teebalroshood/ENCE-3231_EmbeddedSys/2_wheel_project/components/ESP8266-01_ESP-01/step/ESP8266-01_ESP-01.step

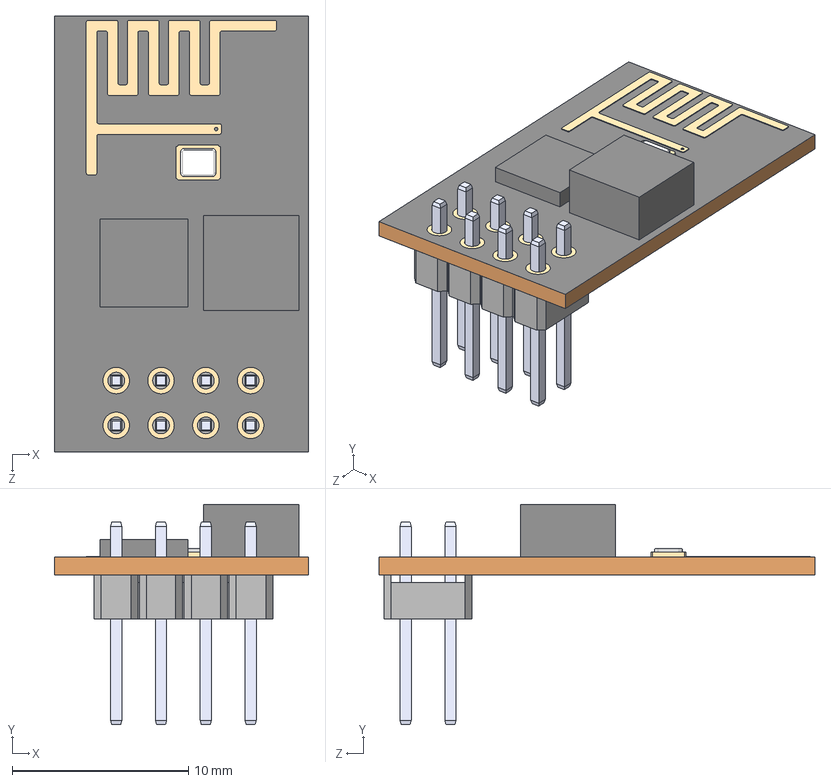
[picture p16: CAD file, 2026-05-04]
2_wheel_project/components/ESP8266-01_ESP-01/step/ESP8266-01_ESP-01.step
14.4 x 12.5 x 24.7 mm
