teebalroshood/ENCE-3231_EmbeddedSys/2_wheel_project/components/Fuse_3DModel/MF-MSMF050-2--3DModel-STEP-56544.STEP

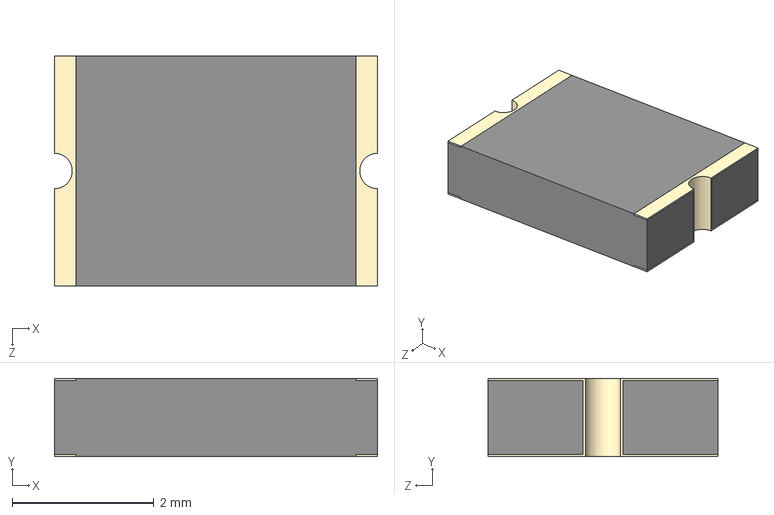
[picture p17: CAD file, 2026-05-04]
2_wheel_project/components/Fuse_3DModel/MF-MSMF050-2--3DModel-STEP-56544.STEP
4.55 x 1.10 x 3.24 mm
