teebalroshood/ENCE-3231_EmbeddedSys/2_wheel_project/components/MPU6050/ITG-MPU.STEP

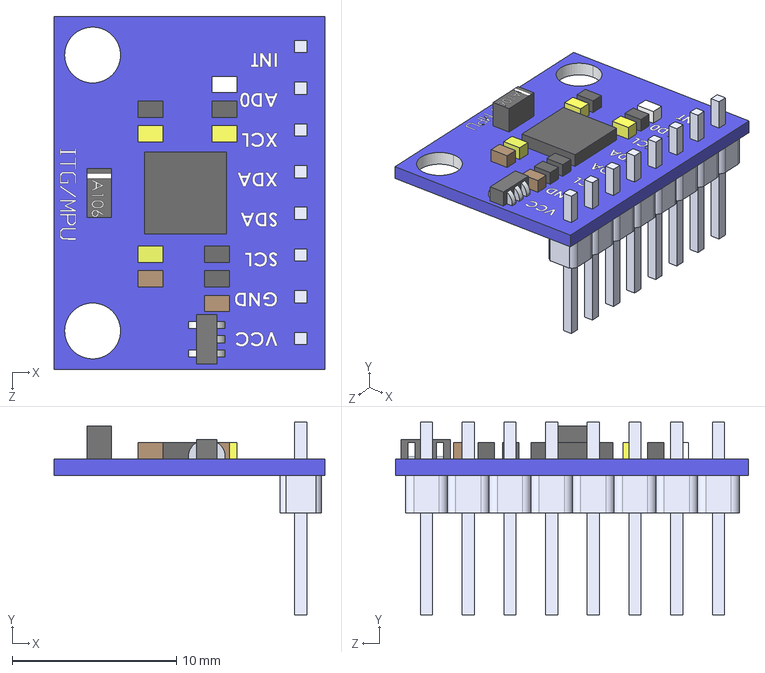
[picture p18: CAD file, 2026-05-04]
2_wheel_project/components/MPU6050/ITG-MPU.STEP
16.5 x 11.8 x 21.5 mm
8 Header-Pin
Placa_Base
