teebalroshood/ENCE-3231_EmbeddedSys/2_wheel_project/components/SPDT_Slide_Switch/step/SLW-66527511-SMT-TR.step

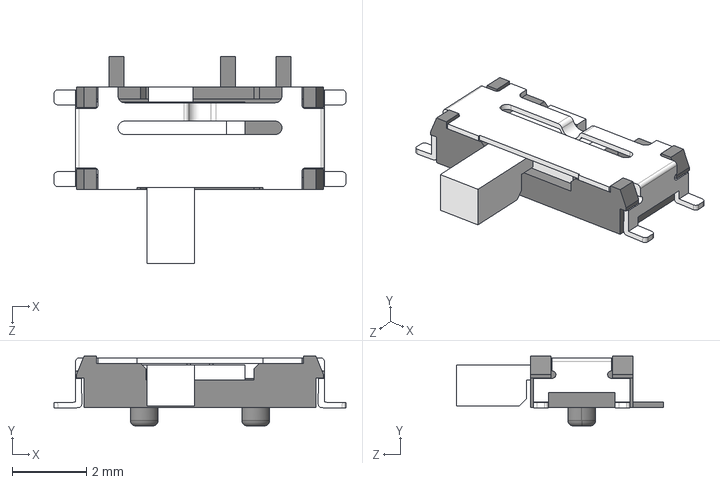
[picture p19: CAD file, 2026-05-04]
2_wheel_project/components/SPDT_Slide_Switch/step/SLW-66527511-SMT-TR.step
7.86 x 1.88 x 5.58 mm
