teebalroshood/ENCE-3231_EmbeddedSys/2_wheel_project/components/SW_uP_Reset/step/SW_uP_Reset.stp

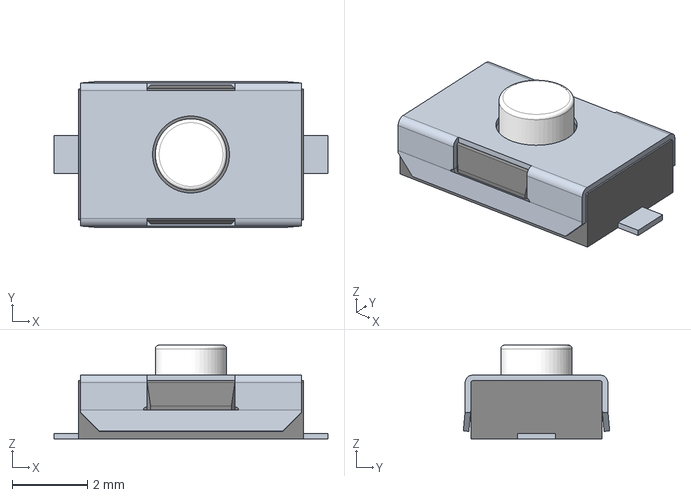
[picture p20: CAD file, 2026-05-04]
2_wheel_project/components/SW_uP_Reset/step/SW_uP_Reset.stp
7.30 x 3.90 x 2.50 mm
