teebalroshood/ENCE-3231_EmbeddedSys/2_wheel_project/Teeb_ES_Project .step

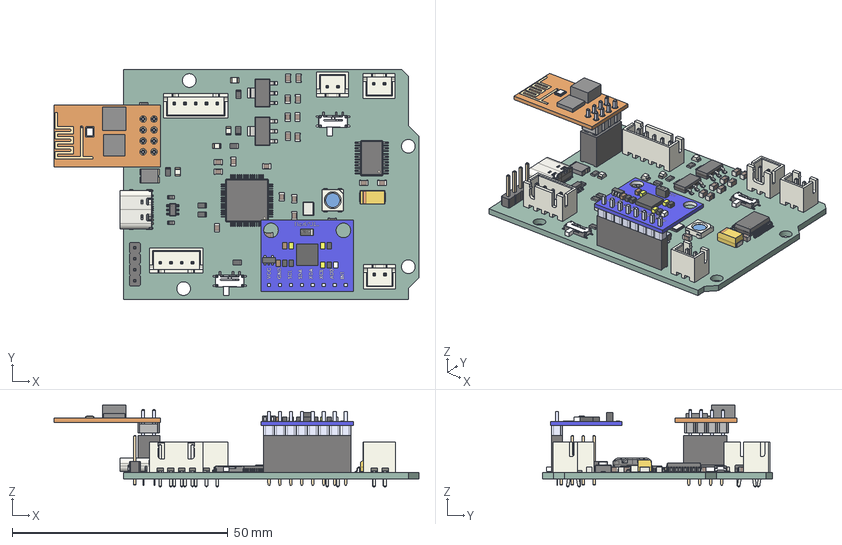
[picture p21: CAD file, 2026-05-08]
2_wheel_project/Teeb_ES_Project .step
84.6 x 53.4 x 19.0 mm
C_0805_2012Metric x 21
MF-MSMF050-2--3DModel-STEP-56544
R_0805_2012Metric x 8
SOT-23-6
SOT-223 x 2
SLW-66527511-SMT-TR x 2
PinSocket_2x04_P2.54mm_Vertical
ESP8266-01_ESP-01
R_0603_1608Metric x 2
SSOP-24_5.3x8.2mm_P0.65mm
LED_WS2812B_PLCC4_5.0x5.0mm_P3.2mm
base
top cover
pins x 2
LQFP-64_10x10mm_P0.5mm
LED_0805_2012Metric x 4
Crystal_SMD_Abracon_ABM8G-4Pin_3.2x2.5mm
JST_XH_B2B-XH-A_1x02_P2.50mm_Vertical x 3
PinHeader_1x04_P2.54mm_Vertical
JST_XH_B5B-XH-A_1x05_P2.50mm_Vertical
USB_C_Receptacle_GCT_USB4105-xx-A_16P_TopMnt_Horizontal
PinSocket_1x08_P2.54mm_Vertical
8 Header-Pin
Placa_Base
CP_EIA-6032-28_Kemet-C
JST_XH_B4B-XH-A_1x04_P2.50mm_Vertical
2026_12_2Wheel_Balance_Robot_v1_PCB
